bristol-communal-modular/bcm-mixer/README.md

# Mixer

A general purpose mixer with two mono input channels and one stereo channel.

Mono Inputs have a gain control with up to 34dB of amplification and a pan control.

Expansion header on the rear will allow additional channels to be incorporated as needed.
