bristol-communal-modular/bcm-mixer/panel/panel.dxf

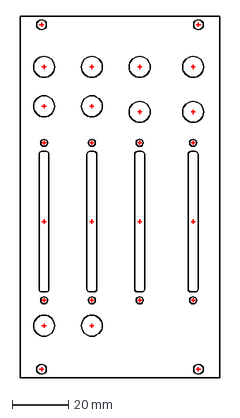
[picture p1: CAD file, 2024-11-17]
panel/panel.dxf
70.8 x 128.5 mm
