bristol-communal-modular/bcm-mixer/kicad/bcm-mixer.kicad_pcb

## KiCad design kicad/bcm-mixer.kicad_pcb (2025-02-16)

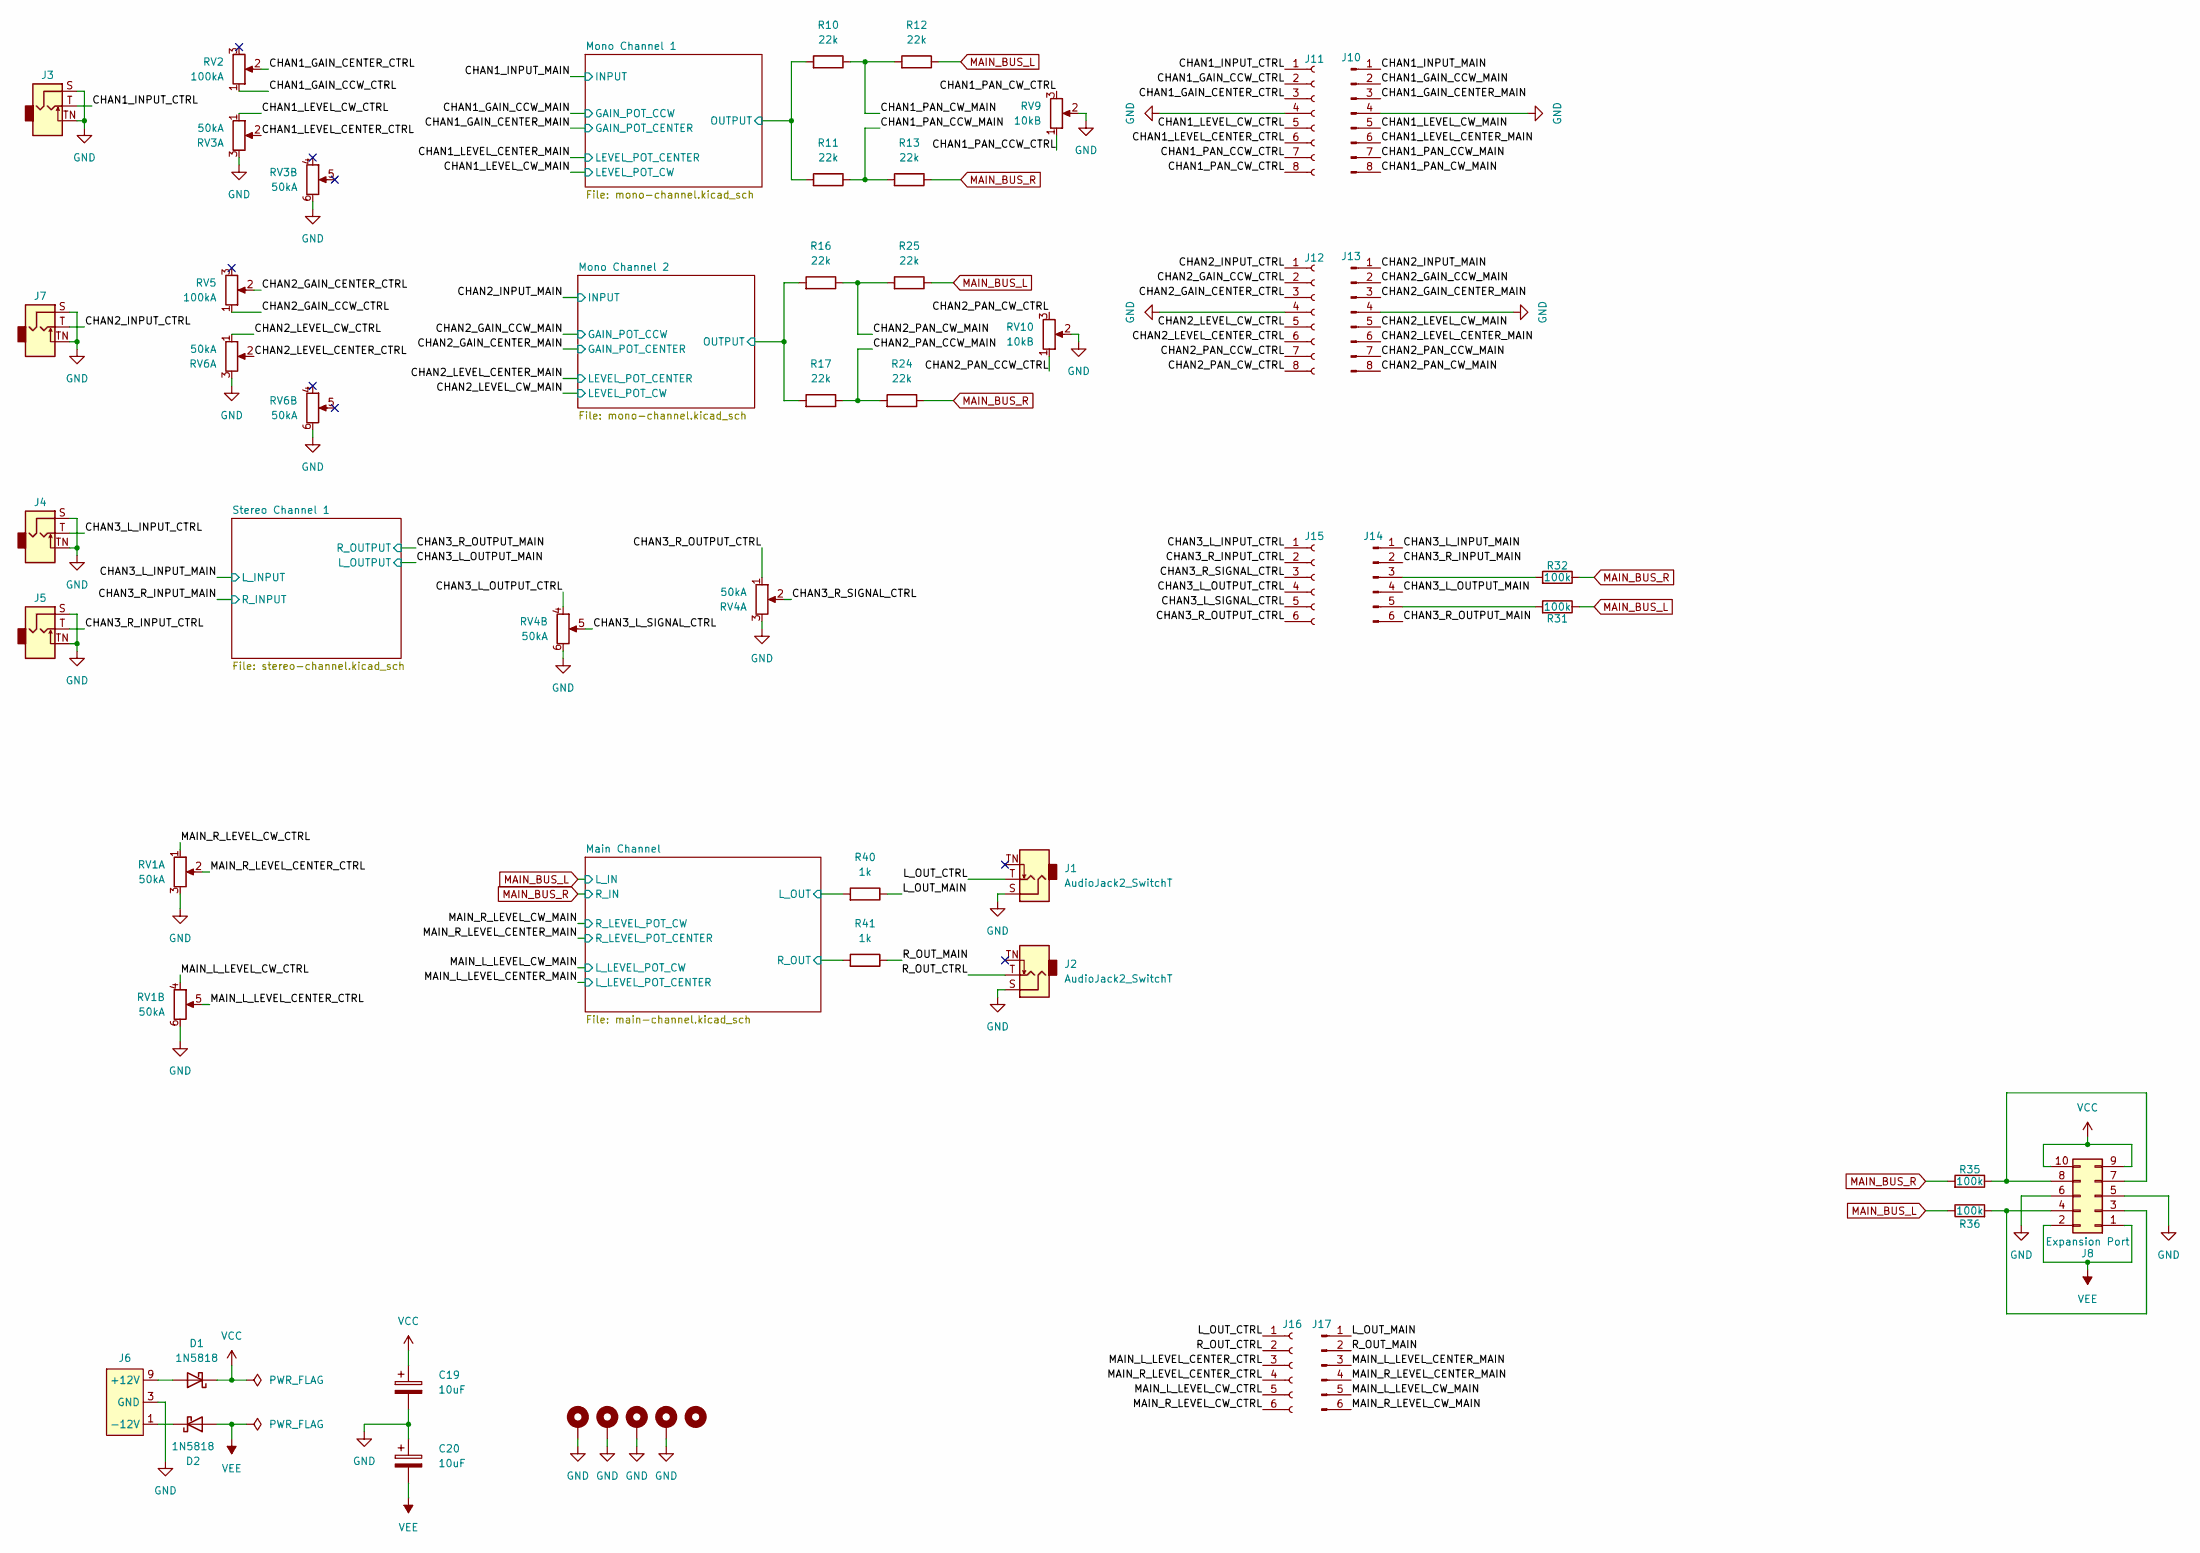
[picture p2: schematic bcm-mixer.kicad_sch, BCM Mixer]

Parts:
C19, C20: 10uF; CP_Radial_D5.0mm_P2.00mm; Tolerance 20%; Voltage 50v
D1, D2: 1N5818; D_DO-41_SOD81_P10.16mm_Horizontal
H1, H2, H3, H4: MountingHole_Pad; MountingHole_3.2mm_M3_DIN965_Pad
H5: MountingHole; MountingHole_3.2mm_M3_DIN965
J1, J2, J3, J4, J5, J7: AudioJack2_SwitchT; Jack_3.5mm_QingPu_WQP-PJ398SM_Vertical
J6: Eurorack Power Small; Eurorack_Power_IDC-Header_2x05_P2.54mm_Vertical
J8: Conn_02x05_Odd_Even; IDC-Header_2x05_P2.54mm_Vertical
J10, J13: Conn_01x08_Pin; PinHeader_1x08_P2.54mm_Vertical
J11, J12: Conn_01x08_Socket; PinSocket_1x08_P2.54mm_Vertical
J14, J17: Conn_01x06_Pin; PinHeader_1x06_P2.54mm_Vertical
J15, J16: Conn_01x06_Socket; PinSocket_1x06_P2.54mm_Vertical
R10, R11, R12, R13, R16, R17, R24, R25: 22k; R_Axial_DIN0207_L6.3mm_D2.5mm_P10.16mm_Horizontal; Tolerance 1%
R31, R32, R35, R36: 100k; R_Axial_DIN0207_L6.3mm_D2.5mm_P10.16mm_Horizontal; Tolerance 1%
R40, R41: 1k; R_Axial_DIN0207_L6.3mm_D2.5mm_P10.16mm_Horizontal; Tolerance 1%
RV1, RV3, RV4, RV6: 50kA; Potentiometer_TTElectronics_PS45_Dual_Frame
RV2, RV5: 100kA; Potentiometer_Alpha_RD901F-40-00D_Single_Vertical
RV9, RV10: 10kB; Potentiometer_Alpha_RD901F-40-00D_Single_Vertical

Connections:
/CHAN1_GAIN_CCW_CTRL: J11.2, RV2.1
/CHAN1_GAIN_CCW_MAIN: J10.2; also elsewhere on the board
/CHAN1_GAIN_CENTER_CTRL: J11.3, RV2.2
/CHAN1_GAIN_CENTER_MAIN: J10.3; also elsewhere on the board
/CHAN1_INPUT_CTRL: J3.T, J11.1
/CHAN1_INPUT_MAIN: J10.1; also elsewhere on the board
/CHAN1_LEVEL_CENTER_CTRL: J11.6, RV3.2
/CHAN1_LEVEL_CENTER_MAIN: J10.6; also elsewhere on the board
/CHAN1_LEVEL_CW_CTRL: J11.5, RV3.1
/CHAN1_LEVEL_CW_MAIN: J10.5; also elsewhere on the board
/CHAN1_PAN_CCW_CTRL: J11.7, RV9.1
/CHAN1_PAN_CCW_MAIN: J10.7, R11.2, R13.1
/CHAN1_PAN_CW_CTRL: J11.8, RV9.3
/CHAN1_PAN_CW_MAIN: J10.8, R10.2, R12.1
/CHAN2_GAIN_CCW_CTRL: J12.2, RV5.1
/CHAN2_GAIN_CCW_MAIN: J13.2; also elsewhere on the board
/CHAN2_GAIN_CENTER_CTRL: J12.3, RV5.2
/CHAN2_GAIN_CENTER_MAIN: J13.3; also elsewhere on the board
/CHAN2_INPUT_CTRL: J7.T, J12.1
/CHAN2_INPUT_MAIN: J13.1; also elsewhere on the board
/CHAN2_LEVEL_CENTER_CTRL: J12.6, RV6.2
/CHAN2_LEVEL_CENTER_MAIN: J13.6; also elsewhere on the board
/CHAN2_LEVEL_CW_CTRL: J12.5, RV6.1
/CHAN2_LEVEL_CW_MAIN: J13.5; also elsewhere on the board
/CHAN2_PAN_CCW_CTRL: J12.7, RV10.1
/CHAN2_PAN_CCW_MAIN: J13.7, R17.2, R24.1
/CHAN2_PAN_CW_CTRL: J12.8, RV10.3
/CHAN2_PAN_CW_MAIN: J13.8, R16.2, R25.1
/CHAN3_L_INPUT_CTRL: J4.T, J15.1
/CHAN3_L_INPUT_MAIN: J14.1; also elsewhere on the board
/CHAN3_L_OUTPUT_CTRL: J15.4, RV4.4
/CHAN3_L_OUTPUT_MAIN: J14.4; also elsewhere on the board
/CHAN3_L_SIGNAL_CTRL: J15.5, RV4.5
/CHAN3_R_INPUT_CTRL: J5.T, J15.2
/CHAN3_R_INPUT_MAIN: J14.2; also elsewhere on the board
/CHAN3_R_OUTPUT_CTRL: J15.6, RV4.1
/CHAN3_R_OUTPUT_MAIN: J14.6; also elsewhere on the board
/CHAN3_R_SIGNAL_CTRL: J15.3, RV4.2
/L_OUT_CTRL: J1.T, J16.1
/L_OUT_MAIN: J17.1, R40.2
/MAIN_L_LEVEL_CENTER_CTRL: J16.3, RV1.5
/MAIN_L_LEVEL_CENTER_MAIN: J17.3; also elsewhere on the board
/MAIN_L_LEVEL_CW_CTRL: J16.5, RV1.4
/MAIN_L_LEVEL_CW_MAIN: J17.5; also elsewhere on the board
/MAIN_R_LEVEL_CENTER_CTRL: J16.4, RV1.2
/MAIN_R_LEVEL_CENTER_MAIN: J17.4; also elsewhere on the board
/MAIN_R_LEVEL_CW_CTRL: J16.6, RV1.1
/MAIN_R_LEVEL_CW_MAIN: J17.6; also elsewhere on the board
/Main Channel/L_OUT: R40.1; also elsewhere on the board
/Main Channel/R_OUT: R41.1; also elsewhere on the board
/Mono Channel 1/OUTPUT: R10.1, R11.1; also elsewhere on the board
/Mono Channel 2/OUTPUT: R16.1, R17.1; also elsewhere on the board
/R_OUT_CTRL: J2.T, J16.2
/R_OUT_MAIN: J17.2, R41.2
GND: C19.2, C20.1, H1.1, H2.1, H3.1, H4.1, J1.S, J2.S, J3.S, J3.TN, J4.S, J4.TN, J5.S, J5.TN, J6.3 (GND), J6.4 (GND), J6.5 (GND), J6.6 (GND), J6.7 (GND), J6.8 (GND), J7.S, J7.TN, J8.5, J8.6, J10.4, J11.4, J12.4, J13.4, RV1.3, RV1.6, RV3.3, RV3.6, RV4.3, RV4.6, RV6.3, RV6.6, RV9.2, RV10.2; also elsewhere on the board
MAIN_BUS_L: R12.2, R25.2, R31.2, R35.2; also elsewhere on the board
MAIN_BUS_R: R13.2, R24.2, R32.2, R36.1; also elsewhere on the board
unnamed: D1.2 (A), J6.9 (+12V), J6.10 (+12V)
unnamed: D2.1 (K), J6.1 (-12V), J6.2 (-12V)
unnamed: J8.3, J8.4, R35.1
unnamed: J8.7, J8.8, R36.2
unnamed: J14.3, R32.1
unnamed: J14.5, R31.1
VCC: C19.1, D1.1 (K), J8.9, J8.10; also elsewhere on the board
VEE: C20.2, D2.2 (A), J8.1, J8.2; also elsewhere on the board

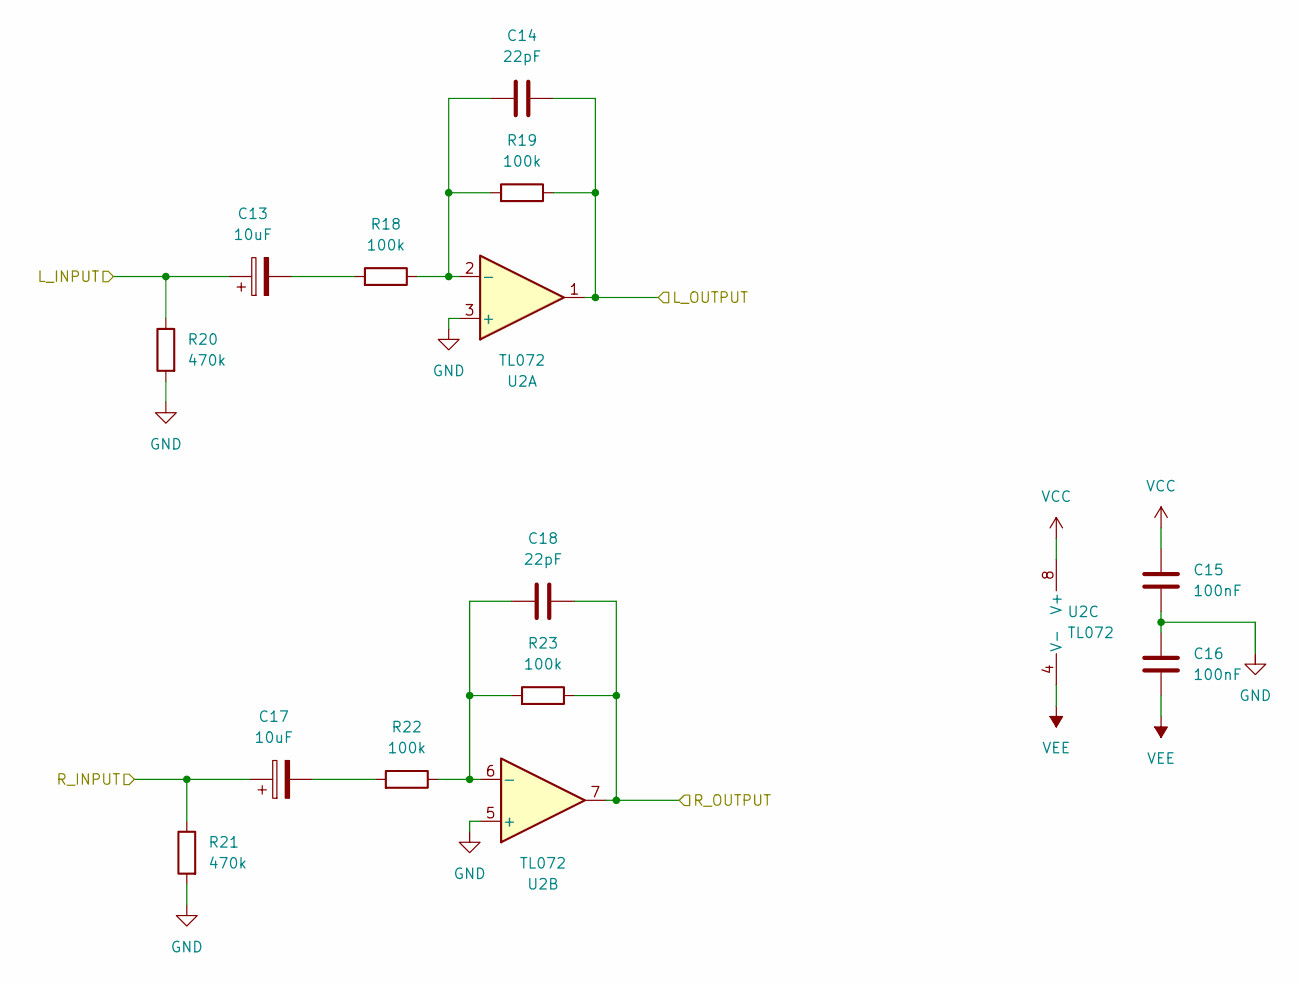
[picture p3: schematic stereo-channel.kicad_sch, BCM Mixer]

Parts:
C13, C17: 10uF; CP_Radial_D5.0mm_P2.00mm; Tolerance 20%; Voltage 50v
C14, C18: 22pF; C_Rect_L7.0mm_W2.5mm_P5.00mm; Tolerance 5%
C15, C16: 100nF; C_Rect_L7.0mm_W2.5mm_P5.00mm; Tolerance 5%
R18, R19, R22, R23: 100k; R_Axial_DIN0207_L6.3mm_D2.5mm_P10.16mm_Horizontal; Tolerance 1%
R20, R21: 470k; R_Axial_DIN0207_L6.3mm_D2.5mm_P10.16mm_Horizontal; Tolerance 1%
U2: TL072; DIP-8_W7.62mm_Socket

Connections:
/CHAN3_L_INPUT_MAIN: C13.1, R20.2; also elsewhere on the board
/CHAN3_L_OUTPUT_MAIN: C14.2, R19.2, U2.1; also elsewhere on the board
/CHAN3_R_INPUT_MAIN: C17.1, R21.2; also elsewhere on the board
/CHAN3_R_OUTPUT_MAIN: C18.2, R23.2, U2.7; also elsewhere on the board
GND: C15.1, C16.2, R20.1, R21.1, U2.3 (+), U2.5 (+); also elsewhere on the board
unnamed: C13.2, R18.1
unnamed: C17.2, R22.1
unnamed: C14.1, R18.2, R19.1, U2.2 (-)
unnamed: C18.1, R22.2, R23.1, U2.6 (-)
VCC: C15.2, U2.8 (V+); also elsewhere on the board
VEE: C16.1, U2.4 (V-); also elsewhere on the board

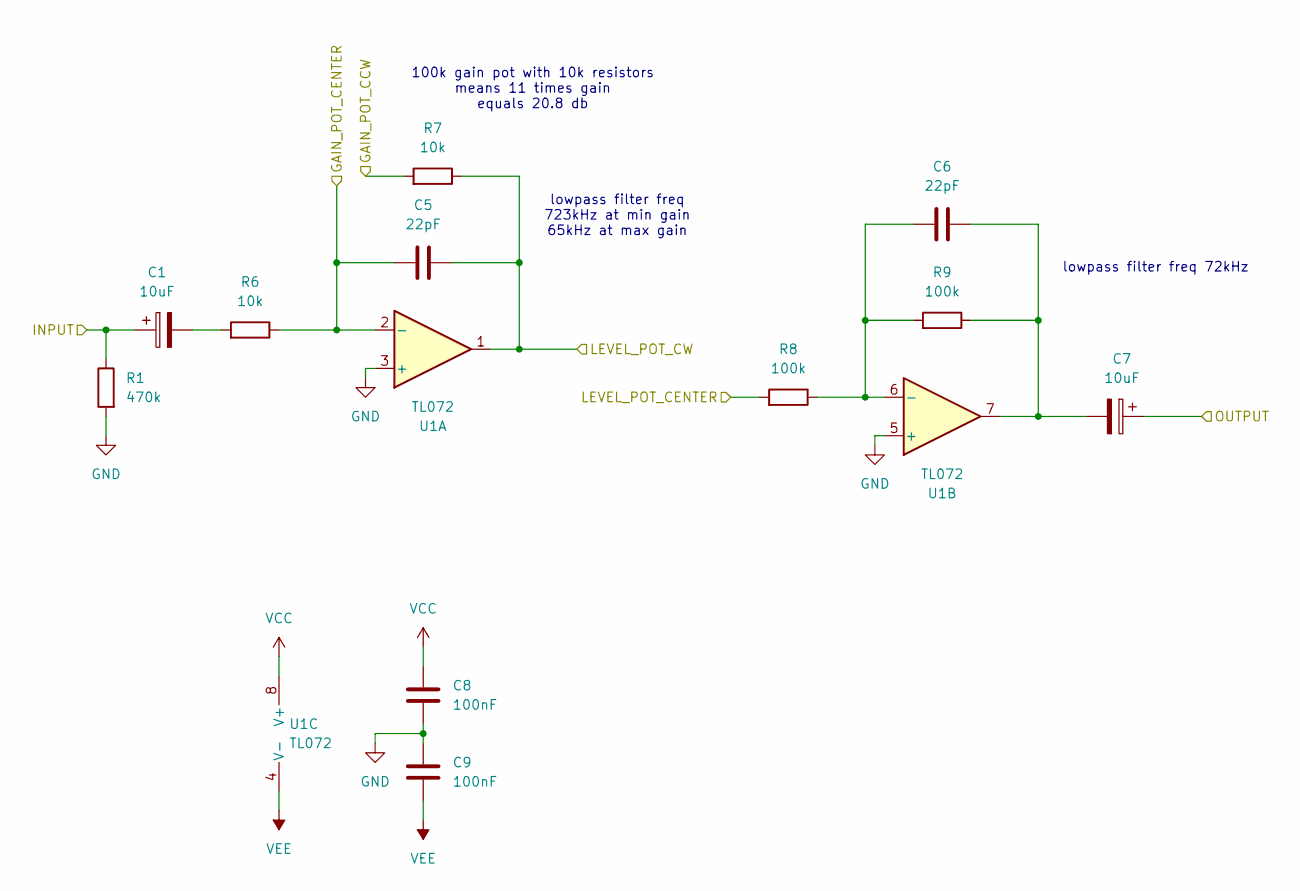
[picture p4: schematic mono-channel.kicad_sch, BCM Mixer]

Parts:
C1, C7: 10uF; CP_Radial_D5.0mm_P2.00mm; Tolerance 20%; Voltage 50v
C5, C6: 22pF; C_Rect_L7.0mm_W2.5mm_P5.00mm; Tolerance 5%
C8, C9: 100nF; C_Rect_L7.0mm_W2.5mm_P5.00mm; Tolerance 5%
R1: 470k; R_Axial_DIN0207_L6.3mm_D2.5mm_P10.16mm_Horizontal; Tolerance 1%
R6, R7: 10k; R_Axial_DIN0207_L6.3mm_D2.5mm_P10.16mm_Horizontal; Tolerance 1%
R8, R9: 100k; R_Axial_DIN0207_L6.3mm_D2.5mm_P10.16mm_Horizontal; Tolerance 1%
U1: TL072; DIP-8_W7.62mm_Socket

Connections:
/CHAN1_GAIN_CCW_MAIN: R7.1; also elsewhere on the board
/CHAN1_GAIN_CENTER_MAIN: C5.1, R6.2, U1.2 (-); also elsewhere on the board
/CHAN1_INPUT_MAIN: C1.1, R1.2; also elsewhere on the board
/CHAN1_LEVEL_CENTER_MAIN: R8.1; also elsewhere on the board
/CHAN1_LEVEL_CW_MAIN: C5.2, R7.2, U1.1; also elsewhere on the board
/Mono Channel 1/OUTPUT: C7.1; also elsewhere on the board
GND: C8.1, C9.2, R1.1, U1.3 (+), U1.5 (+); also elsewhere on the board
unnamed: C1.2, R6.1
unnamed: C6.2, C7.2, R9.2, U1.7
unnamed: C6.1, R8.2, R9.1, U1.6 (-)
VCC: C8.2, U1.8 (V+); also elsewhere on the board
VEE: C9.1, U1.4 (V-); also elsewhere on the board

Parts of its further copies:
C21, C26: 10uF; CP_Radial_D5.0mm_P2.00mm; Tolerance 20%; Voltage 50v
C22, C25: 22pF; C_Rect_L7.0mm_W2.5mm_P5.00mm; Tolerance 5%
C23, C24: 100nF; C_Rect_L7.0mm_W2.5mm_P5.00mm; Tolerance 5%
R26: 470k; R_Axial_DIN0207_L6.3mm_D2.5mm_P10.16mm_Horizontal; Tolerance 1%
R27, R28: 10k; R_Axial_DIN0207_L6.3mm_D2.5mm_P10.16mm_Horizontal; Tolerance 1%
R29, R30: 100k; R_Axial_DIN0207_L6.3mm_D2.5mm_P10.16mm_Horizontal; Tolerance 1%
U4: TL072; DIP-8_W7.62mm_Socket

Connections of its further copies:
/CHAN2_GAIN_CCW_MAIN: R28.1; also elsewhere on the board
/CHAN2_GAIN_CENTER_MAIN: C22.1, R27.2, U4.2 (-); also elsewhere on the board
/CHAN2_INPUT_MAIN: C21.1, R26.2; also elsewhere on the board
/CHAN2_LEVEL_CENTER_MAIN: R29.1; also elsewhere on the board
/CHAN2_LEVEL_CW_MAIN: C22.2, R28.2, U4.1; also elsewhere on the board
/Mono Channel 2/OUTPUT: C26.1; also elsewhere on the board
GND: C23.1, C24.2, R26.1, U4.3 (+), U4.5 (+); also elsewhere on the board
unnamed: C21.2, R27.1
unnamed: C25.2, C26.2, R30.2, U4.7
unnamed: C25.1, R29.2, R30.1, U4.6 (-)
VCC: C23.2, U4.8 (V+); also elsewhere on the board
VEE: C24.1, U4.4 (V-); also elsewhere on the board

Notes on the sheet:
100k gain pot with 10k resistors means 11 times gain equals 20.8 db
lowpass filter freq 72kHz
lowpass filter freq 723kHz at min gain 65kHz at max gain

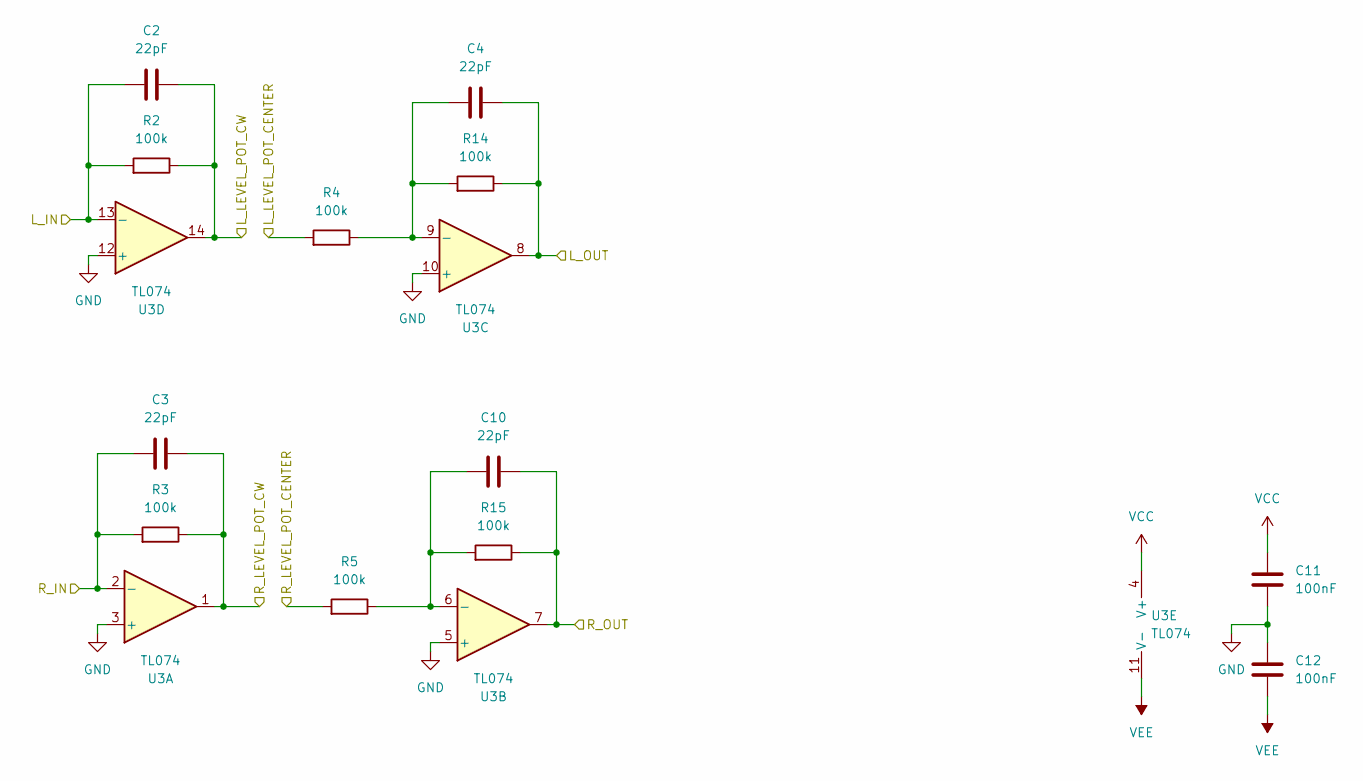
[picture p5: schematic main-channel.kicad_sch, BCM Mixer]

Parts:
C2, C3, C4, C10: 22pF; C_Rect_L7.0mm_W2.5mm_P5.00mm; Tolerance 5%
C11, C12: 100nF; C_Rect_L7.0mm_W2.5mm_P5.00mm; Tolerance 5%
R2, R3, R4, R5, R14, R15: 100k; R_Axial_DIN0207_L6.3mm_D2.5mm_P10.16mm_Horizontal; Tolerance 1%
U3: TL074; DIP-14_W7.62mm_Socket_LongPads

Connections:
/MAIN_L_LEVEL_CENTER_MAIN: R4.1; also elsewhere on the board
/MAIN_L_LEVEL_CW_MAIN: C2.2, R2.2, U3.14; also elsewhere on the board
/MAIN_R_LEVEL_CENTER_MAIN: R5.1; also elsewhere on the board
/MAIN_R_LEVEL_CW_MAIN: C3.2, R3.2, U3.1; also elsewhere on the board
/Main Channel/L_OUT: C4.2, R14.2, U3.8; also elsewhere on the board
/Main Channel/R_OUT: C10.2, R15.2, U3.7; also elsewhere on the board
GND: C11.1, C12.2, U3.3 (+), U3.5 (+), U3.10 (+), U3.12 (+); also elsewhere on the board
MAIN_BUS_L: C2.1, R2.1, U3.13 (-); also elsewhere on the board
MAIN_BUS_R: C3.1, R3.1, U3.2 (-); also elsewhere on the board
unnamed: C10.1, R5.2, R15.1, U3.6 (-)
unnamed: C4.1, R4.2, R14.1, U3.9 (-)
VCC: C11.2, U3.4 (V+); also elsewhere on the board
VEE: C12.1, U3.11 (V-); also elsewhere on the board

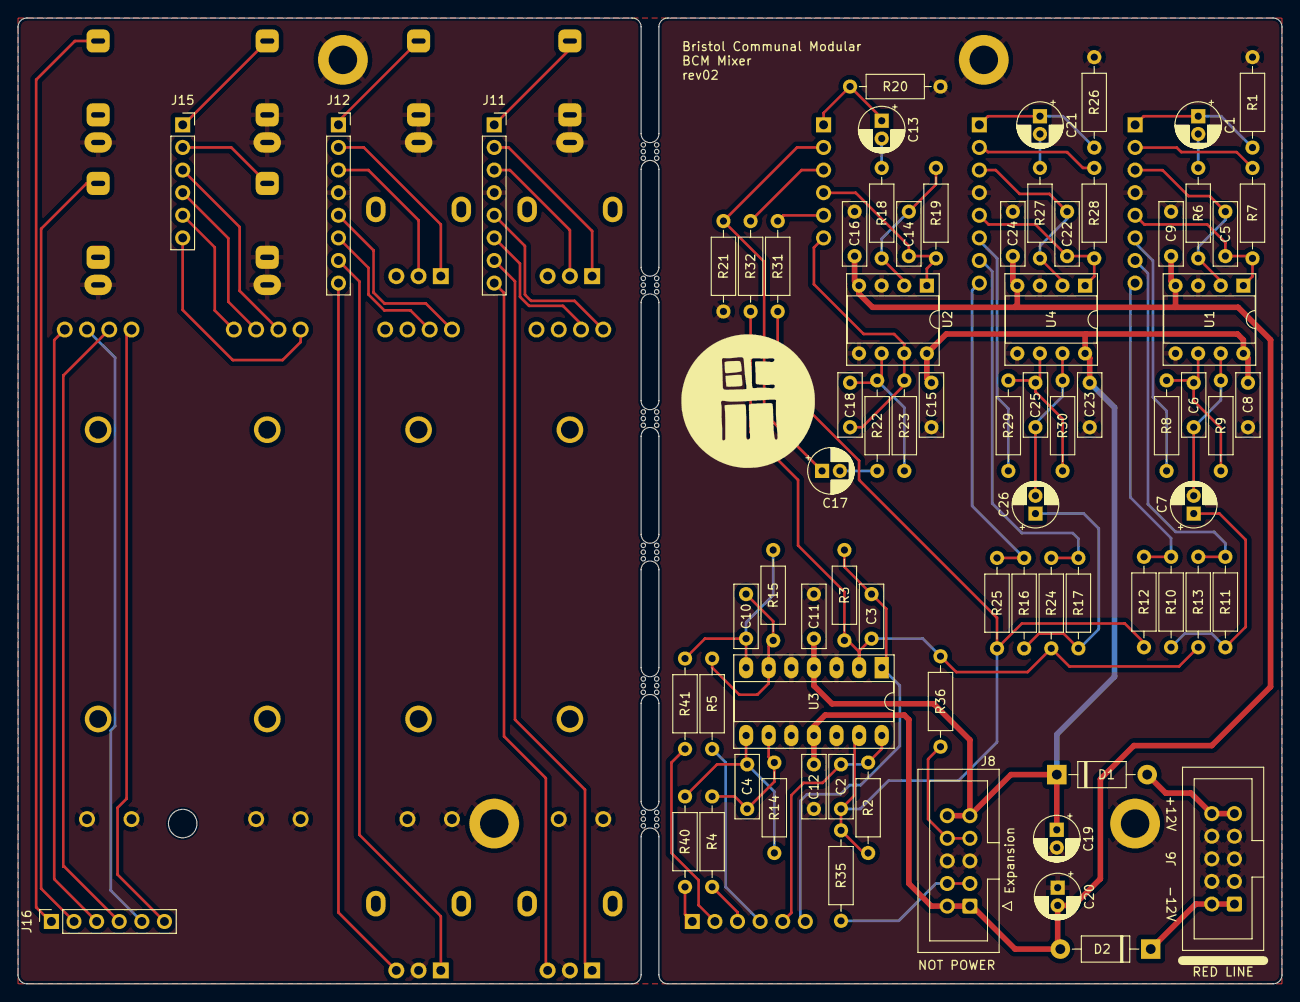
[picture p6: board bcm-mixer.kicad_pcb from above]

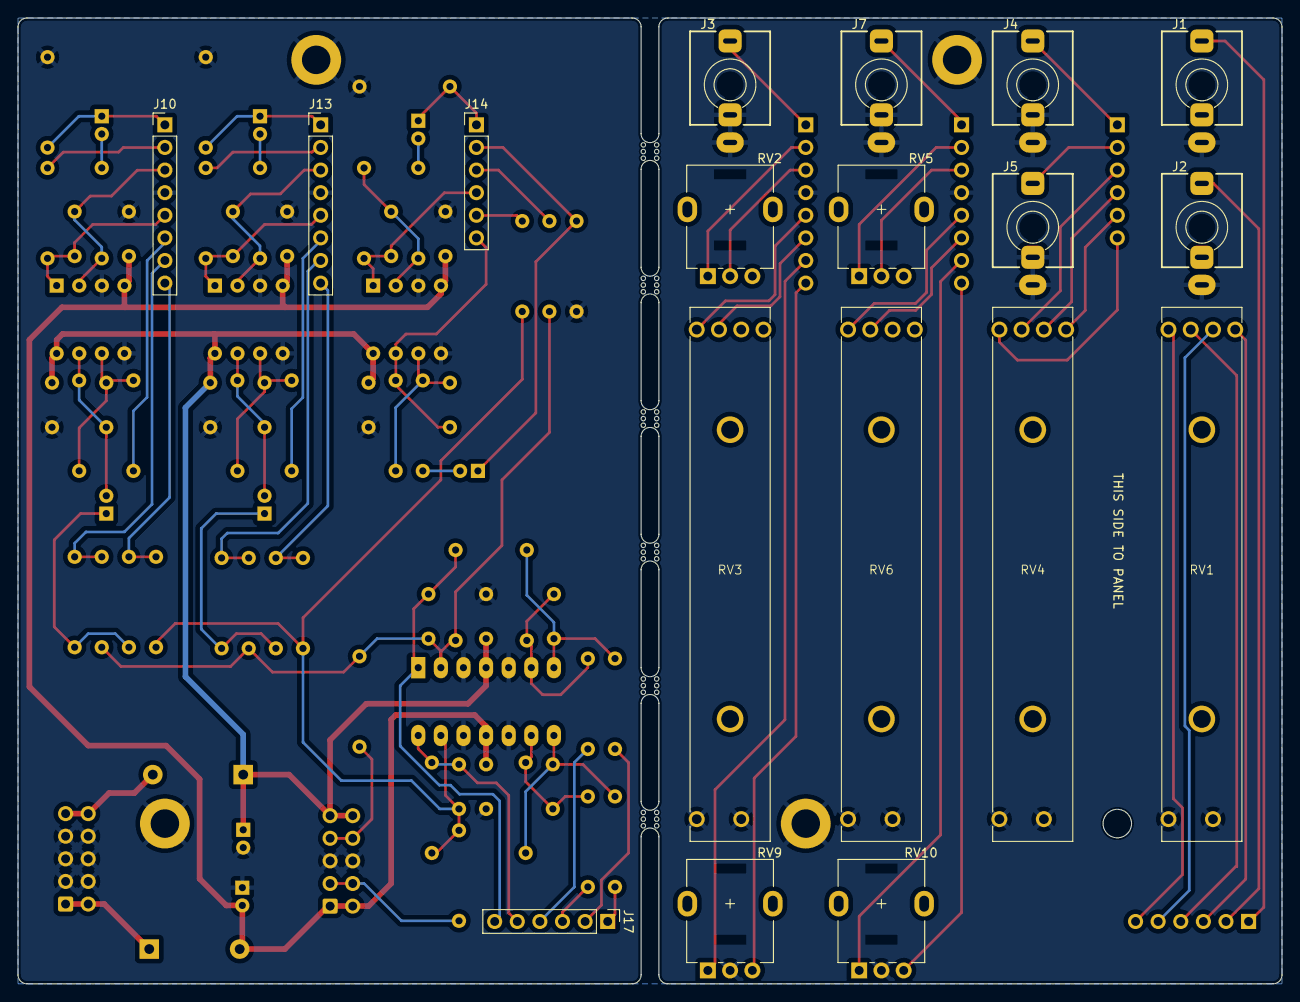
[picture p7: board bcm-mixer.kicad_pcb from below]

Board: 2 copper layers, 142.0 x 108.5 mm, 104 parts (18 on the bottom side), 77 nets.

Other parts of the board:
Ref**: Val**; BCM_Logo_small_15mmx15mm
mouse-bite-2mm-slot, mouse-bite-2mm-slot#2, mouse-bite-2mm-slot#3, mouse-bite-2mm-slot#4, mouse-bite-2mm-slot#5, mouse-bite-2mm-slot#6: VAL**; mouse-bite-2mm-slot
