bristol-communal-modular/bcm-mixer/(commit log)

2024-12-05 Updating everything and adding gerbers
    [bcm-mixer-B_Cu.gbl, bcm-mixer-B_Mask.gbs, bcm-mixer-B_Silkscreen.gbo, bcm-mixer-Edge_Cuts.gm1, bcm-mixer-F_Cu.gtl, bcm-mixer-F_Mask.gts, bcm-mixer-F_Silkscreen.gto, bcm-mixer-NPTH.drl]
2024-12-19 Regenerating gerbers
    [bcm-mixer-B_Cu.gbl, bcm-mixer-B_Mask.gbs, bcm-mixer-B_Silkscreen.gbo, bcm-mixer-Edge_Cuts.gm1, bcm-mixer-F_Cu.gtl, bcm-mixer-F_Mask.gts, bcm-mixer-F_Silkscreen.gto, bcm-mixer-NPTH.drl]
2025-01-19 Updating power header symbol
    [bcm-mixer.kicad_pcb, bcm-mixer.kicad_sch, main-channel.kicad_sch, mono-channel.kicad_sch, stereo-channel.kicad_sch]
2025-01-22 Update slide pot values based on what's actually available
    [bcm-mixer.kicad_sch]
2025-02-16 Updating for revision 2
    [bcm-mixer-B_Cu.gbl, bcm-mixer-B_Mask.gbs, bcm-mixer-B_Silkscreen.gbo, bcm-mixer-Edge_Cuts.gm1, bcm-mixer-F_Cu.gtl, bcm-mixer-F_Mask.gts, bcm-mixer-F_Silkscreen.gto, bcm-mixer-NPTH.drl]
