bristol-communal-modular/bcm-mixer/(notices)

Notices in the files:
kicad/main-channel.kicad_sch:
creativecommons.org/licenses/by/4.0
License: CC BY 4.0
